Galaxy-YLX/Smart_Trashbin/参考/3，STM32例程/【正点原子】战舰V4 STM32F103开发板/02 相对位置模式控制/readme.txt

/**
 ***************************************************************************************************
 * 实验简介
 * 实验名称：步进电机驱动器 实验
 * 实验平台：正点原子 战舰F103开发板
 * 实验目的：学习步进电机驱动器的使用

 ***************************************************************************************************
 * 硬件资源及引脚分配
 * 1 LED灯
     DS0（RED）     : LED0 - PB5
     DS1（GREEN）   : LED1 - PE5
 * 2 串口1 (PA9/PA10连接在板载USB转串口芯片CH340上面，用于打印显示)
 * 3 串口2 (PA2/PA3连接在步进电机驱动器上面，用于发送控制指令)

 ***************************************************************************************************
 * 实验现象
 * 根据不同功能函数控制步进电机驱动器完成不用动作

 ***************************************************************************************************
 * 注意事项
 * 无

 ***********************************************************************************************************
 * 公司名称：广州市星翼电子科技有限公司（正点原子）
 * 电话号码：020-38271790
 * 传真号码：020-36773971
 * 公司网址：www.alientek.com
 * 购买地址：zhengdianyuanzi.tmall.com
 * 技术论坛：http://www.openedv.com/forum.php
 * 最新资料：www.openedv.com/docs/index.html
 *
 * 在线视频：www.yuanzige.com
 * B 站视频：space.bilibili.com/394620890
 * 公 众 号 ：mp.weixin.qq.com/s/y--mG3qQT8gop0VRuER9bw
 * 抖     音 ：douyin.com/user/MS4wLjABAAAAi5E95JUBpqsW5kgMEaagtIITIl15hAJvMO8vQMV1tT6PEsw-V5HbkNLlLMkFf1Bd
 ***********************************************************************************************************
 */
