Galaxy-YLX/Smart_Trashbin/Snipaste_2026-10-28_19-31-28.png

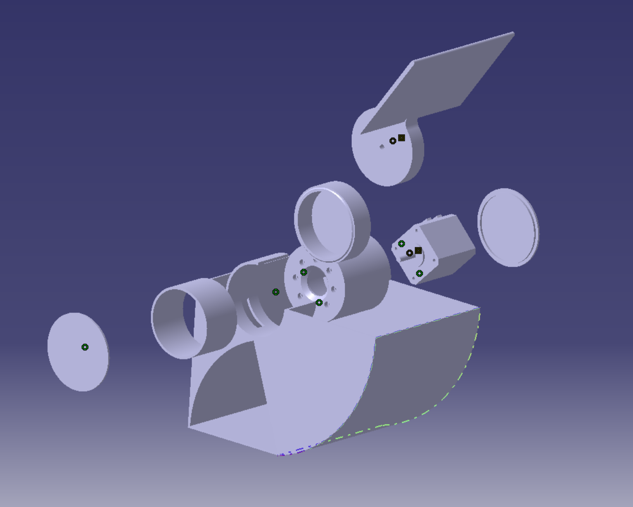
Snipaste_2026-10-28_19-31-28.png
