Galaxy-YLX/Smart_Trashbin/Snipaste_2026-10-28_19-33-47.png

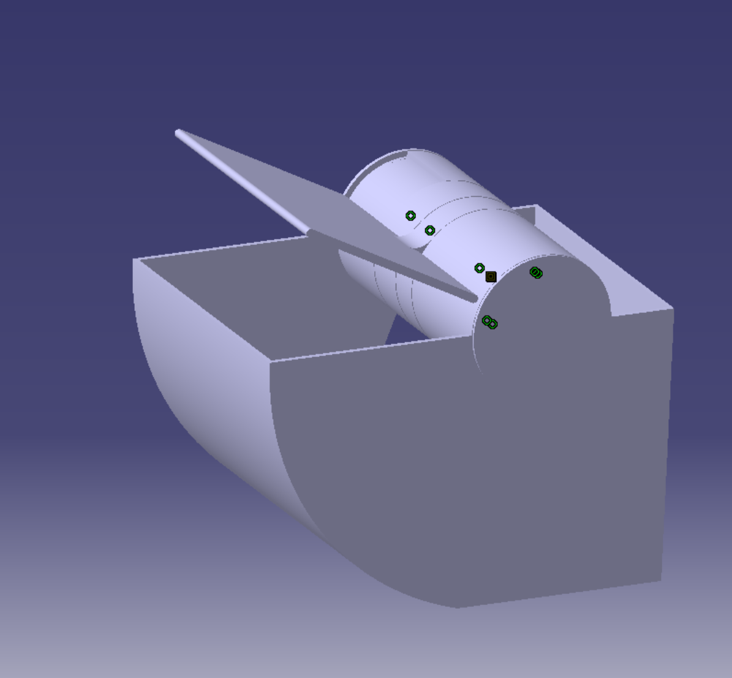
Snipaste_2026-10-28_19-33-47.png
