Galaxy-YLX/Smart_Trashbin/参考/3，STM32例程/【正点原子】战舰V4 STM32F103开发板/【正点原子】战舰V4 STM32F103开发板与PD42S1硬件连接图（RS485）.bmp

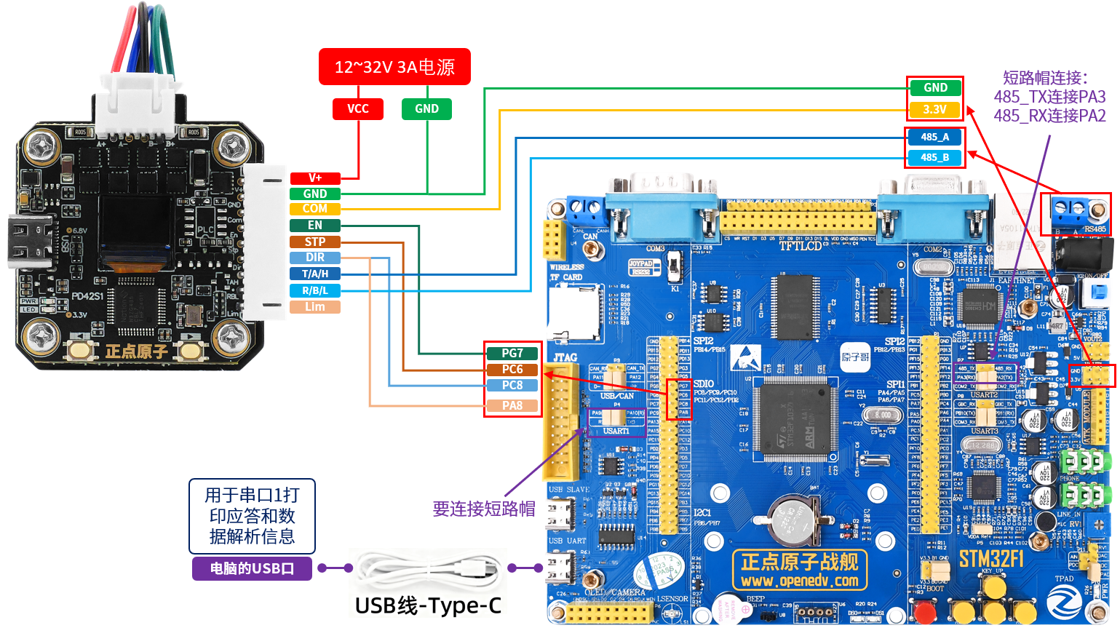
参考/3，STM32例程/【正点原子】战舰V4 STM32F103开发板/【正点原子】战舰V4 STM32F103开发板与PD42S1硬件连接图（RS485）.bmp
