Galaxy-YLX/Smart_Trashbin/参考/DTOF-5310/DTOF-2510/╩Σ│÷╕±╩╜.jpg

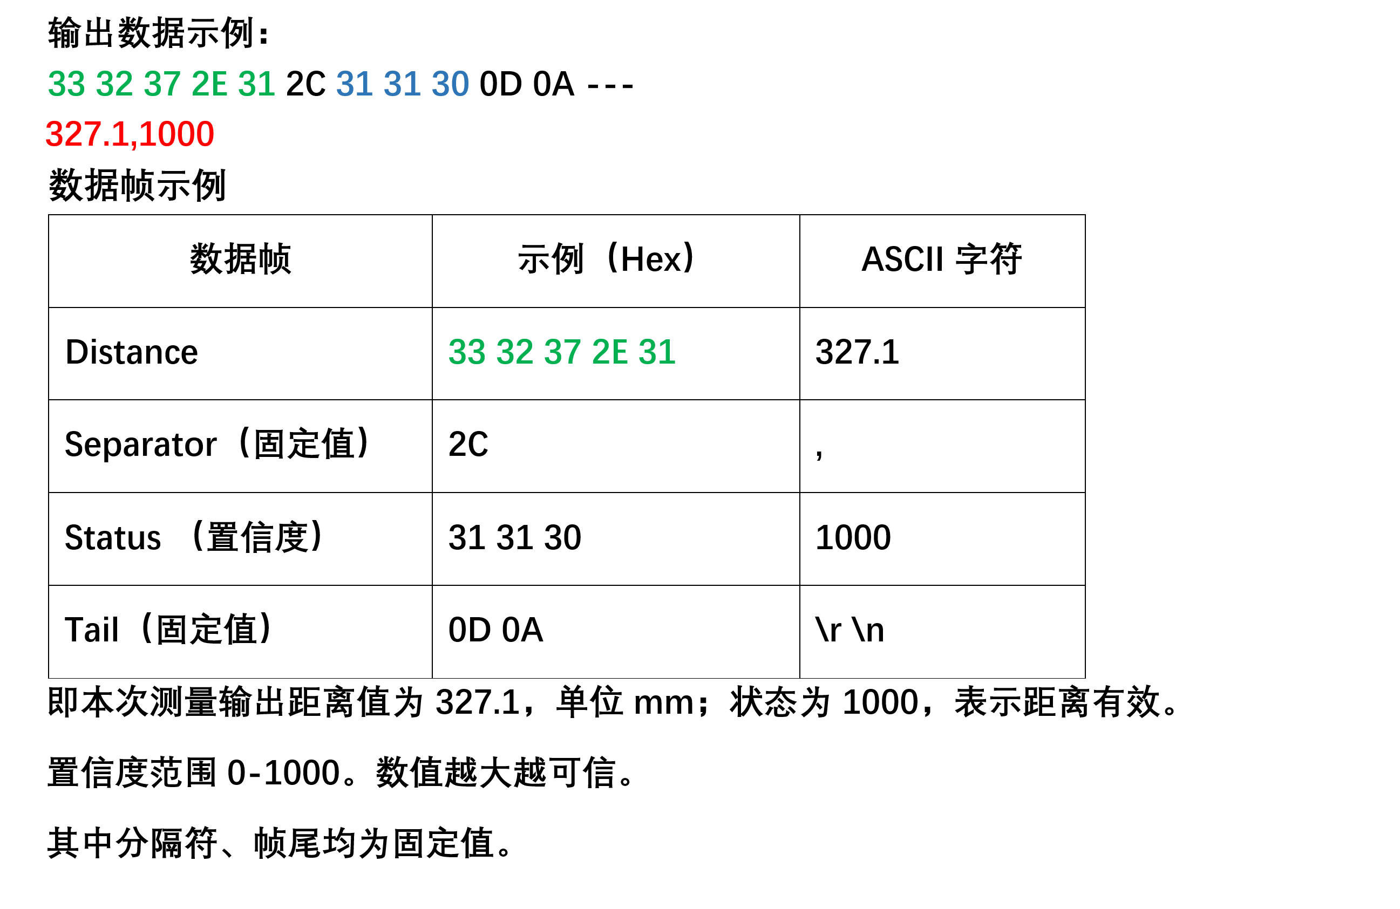
参考/DTOF-5310/DTOF-2510/╩Σ│÷╕±╩╜.jpg
