Galaxy-YLX/Smart_Trashbin/参考/DTOF-5310/DTOF-2510/DTOF-2510.stp

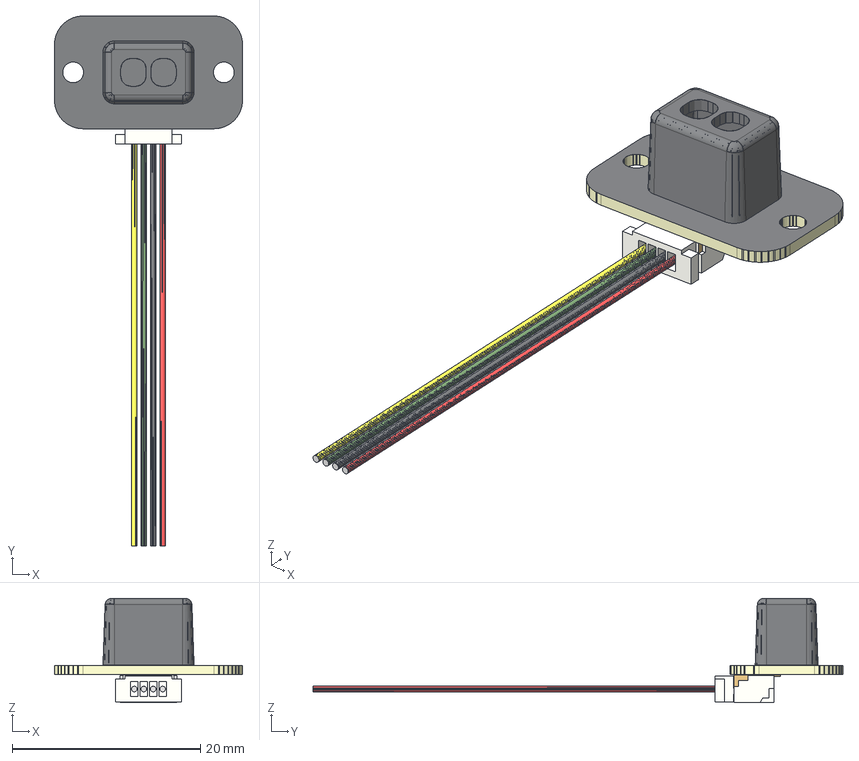
[picture p21: CAD file, 2026-10-28]
参考/DTOF-5310/DTOF-2510/DTOF-2510.stp
20.0 x 56.3 x 11.1 mm
BOARD_DBJJ
TAO
SM04B-SRSS-TB
SHR-04V-S-B
