Galaxy-YLX/Smart_Trashbin/模型文件/Part1.stp

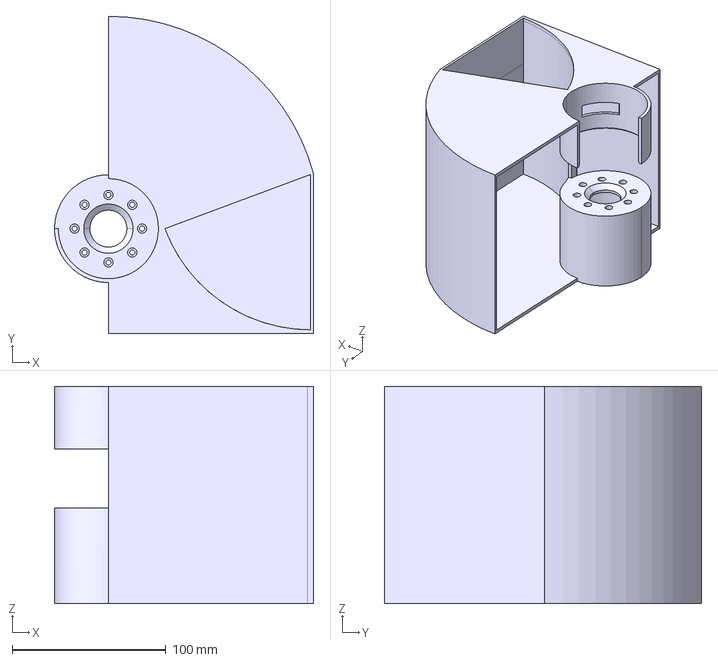
[picture p22: CAD file, 2026-10-28]
模型文件/Part1.stp
168.2 x 206.1 x 141.0 mm
