Galaxy-YLX/Smart_Trashbin/模型文件/tr/Part5.stp

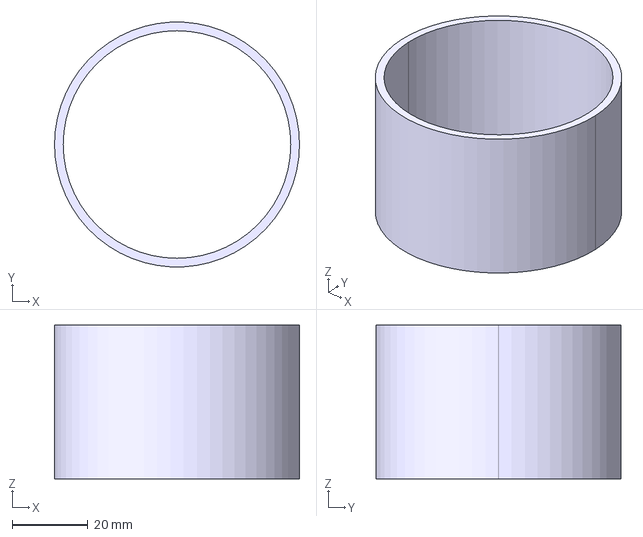
[picture p23: CAD file, 2026-10-28]
模型文件/tr/Part5.stp
64.6 x 64.5 x 40.5 mm
