Galaxy-YLX/Smart_Trashbin/模型文件/Part4.stp

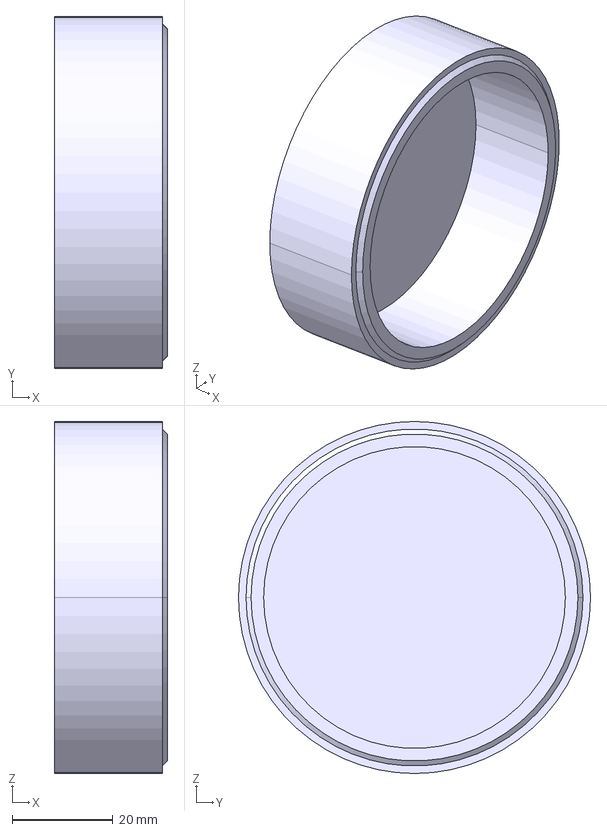
[picture p24: CAD file, 2026-10-28]
模型文件/Part4.stp
22.5 x 70.0 x 70.0 mm
