Galaxy-YLX/Smart_Trashbin/模型文件/Part2.stp

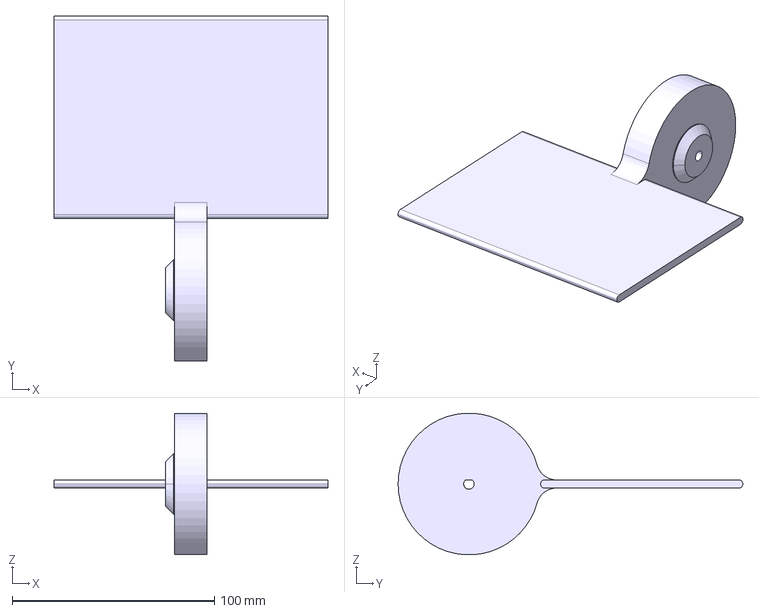
[picture p25: CAD file, 2026-10-28]
模型文件/Part2.stp
135.4 x 170.4 x 69.9 mm
