Galaxy-YLX/Smart_Trashbin/模型文件/Part3.stp

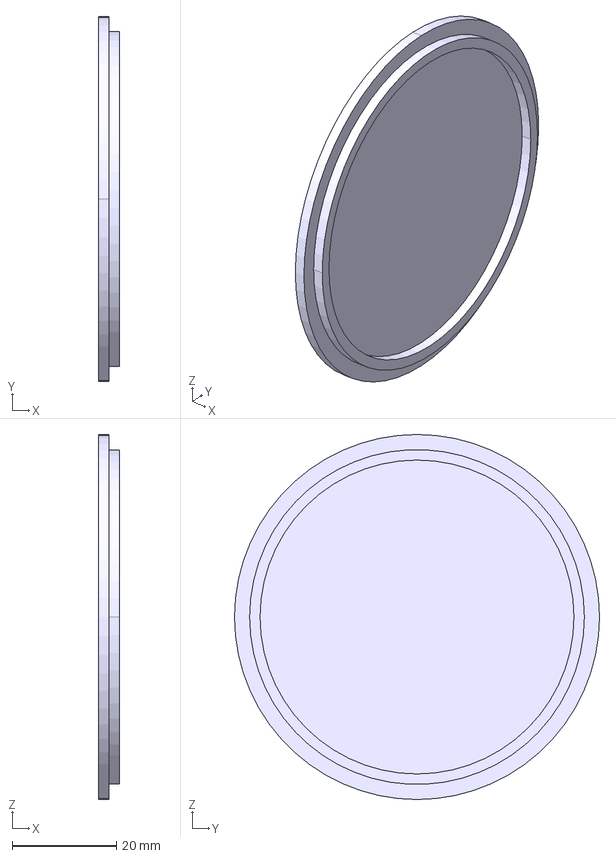
[picture p26: CAD file, 2026-10-28]
模型文件/Part3.stp
4.00 x 70.0 x 70.0 mm
