Galaxy-YLX/Smart_Trashbin/(list of files, cad)

Other CAD files:
模型文件/Motor.CATPart
模型文件/Part1.CATPart
模型文件/Part2.CATPart
模型文件/Part3.CATPart
模型文件/Part4.CATPart
模型文件/Part5.CATPart
模型文件/Trash house.CATProduct
模型文件/新建文件夹/Part1.CATPart
模型文件/新建文件夹/Part2.CATPart
模型文件/新建文件夹/Part3.CATPart
