Galaxy-YLX/Smart_Trashbin/参考/DTOF-5310/DTOF-2510/Code_Demo/STM32_DTOF-2510-DEMO/BSP/delay.h

#ifndef __DELAY_H
#define __DELAY_H

#include "stm32f10x.h"
#include "system_stm32f10x.h"

void delay_init(void);
void delay_ms(uint16_t nms);
void delay_us(uint32_t nus);
void FUN_delay_s(float s);

#endif
