Galaxy-YLX/Smart_Trashbin/(commit log)

2026-10-27 增加参考文档
2026-10-27 往期参考文件
2026-10-27 添加智能垃圾桶控制代码，支持M5Stack Tab5和RS485通信
2026-10-27 重构主程序注释，统一中英文描述，提升可读性
2026-10-27 增加设置位置循环最大电流的功能，优化开关盖和压缩操作的力控制
2026-10-27 增加命令回显设置功能，优化串口通信调试
2026-10-27 优化容量检查逻辑，增加位置采样窗口和静止判断，提升垃圾桶压缩能力的准确性
2026-10-27 修正命令回显设置注释，明确0x6F命令在该电机单元的语义反转，避免误操作
2026-10-27 优化代码注释，统一格式，提升可读性
2026-10-27 优化开关盖操作的静止判断逻辑，增加目标容差，提升开关盖成功率
2026-10-28 新增基于STM32的温控风扇设计报告文档
2026-10-28 更新波特率设置为921600，以提高传输速度
2026-10-28 优化传感器数据处理逻辑，确保每次读取最新距离值，避免缓冲区累积
2026-10-28 更新文档和代码以支持DTOF-2510 ToF传感器，修改距离单位为毫米
2026-10-28 新增自动开盖功能，当测距值 ≤ 200 mm 时触发开盖
2026-10-28 新增自动关盖功能，手离开后延时 10 秒自动关盖
2026-10-28 新增智能垃圾桶控制系统设计报告文档
2026-10-28 增加建模截图及模型文件
2026-10-28 更新设计报告文档，调整格式并添加签名区域
2026-10-28 更新设计报告文档，修正学生学号和指导教师信息
2026-10-28 更新设计报告文档，修正学生姓名和学号信息
2026-10-28 调整界面布局，优化标签位置和按钮尺寸
2026-10-28 新增系统总体框图
2026-10-28 更新设计报告文档，修正日期格式及系统名称
2026-10-28 标题修改
2026-10-28 优化自动关闭逻辑，增加每3秒检查盖子状态的功能
2026-10-29 修正文档标题格式，更新电机供电说明及测距传感器引脚交叉标注
