Galaxy-YLX/Smart_Trashbin/(notices)

Notices in the files:
参考/3，STM32例程/【正点原子】战舰V4 STM32F103开发板/01 绝对位置模式控制/User/main.c:
@license Copyright (c) 2020-2032, ¹ãÖÝÊÐÐÇÒíµç×Ó¿Æ¼¼ÓÐÏÞ¹«Ë¾
